ThatOneNeji/pomodoro/cad/original/Pomodoro - Knob.stl

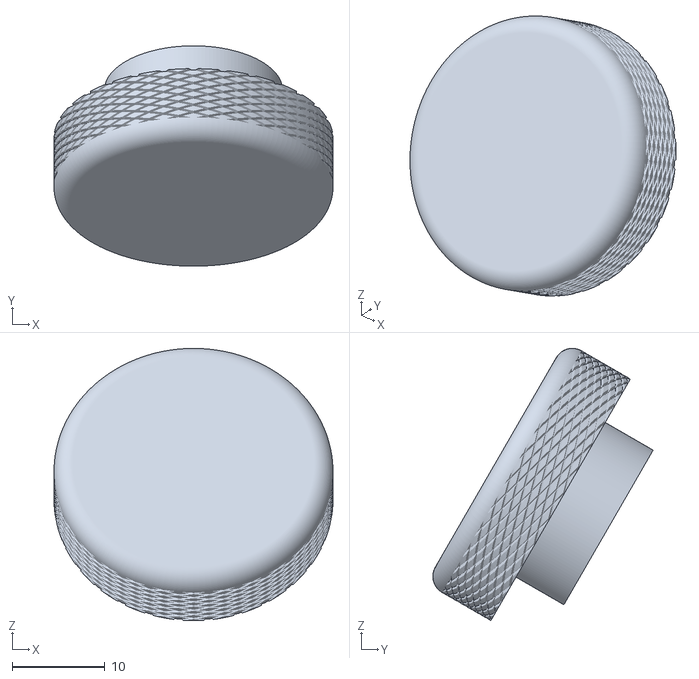
[picture p1: CAD file, 2026-10-10]
cad/original/Pomodoro - Knob.stl
30.0 x 23.7 x 29.3
