ThatOneNeji/pomodoro/src/config.h

/**
 * @file config.h
 * @brief Board wiring (e-paper SPI pins) and user-facing build-time options.
 */
#pragma once

#include <Arduino.h>
#include "credentials.h"
#include <GxEPD2_BW.h>
#include <GxEPD2_GFX.h>

#include "fonts.h"  // declarations only; see fonts.h for why

/// Whether the one-off Anniversary presentation (see anniversary.h) is compiled in. Currently unimplemented.
#define ANNIVERSARY_MODE false

/**
 * @brief Whether the "LPE" meme art (alternate preset icons, running background and long-break
 * images) is compiled in, along with the "LPE Mode" setting that switches to it.
 *
 * Off by default: it costs ~250 KB of flash, and some of the images are third-party works. When
 * off, the setting is hidden and only the neutral assets exist. Which assets count as meme art
 * is marked in assets/manifest.json. Can also be set from platformio.ini with
 * `-DINCLUDE_MEME_ASSETS=1`.
 */
#ifndef INCLUDE_MEME_ASSETS
#define INCLUDE_MEME_ASSETS 0
#endif

/// @name Named font aliases
/// Semantic names for the GFXfont bitmap fonts, used throughout the UI drawing code.
/// @{
#define TITLE_FONT FunnelDisplay_Bold32pt7b       ///< Screen/section titles.
#define MAIN_FONT FunnelDisplay_Bold24pt7b        ///< Primary content text (e.g. preset names).
#define TEXT_FONT FunnelDisplay_Regular14pt7b     ///< General body text.
#define SECONDARY_FONT FunnelDisplay_Bold18pt7b   ///< Secondary/supporting text.
#define SUB_FONT HelvetiPixel24pt7b               ///< Menu bar and subtitle text.
#define SMALL_FONT HelvetiPixel16pt7b             ///< Small/compact text (e.g. speech-bubble messages).
#define SEMI_LARGE_FONT FunnelDisplay_Bold48pt7b  ///< Large emphasis text.
#define LARGE_FONT FunnelDisplay_Bold60pt7b       ///< Largest text (e.g. the countdown display).
/// @}

/// How long the boot splash screen (logo) is shown before preset selection, in milliseconds.
#define SPLASH_DURATION_MS 3000

/// Slow display redraw interval, in milliseconds.
#define REDRAW_INTERVAL_SLOW 1000

/// Concrete GxEPD2 display type in use (480px-wide 4.26" GDEQ0426T82 panel), used wherever display references are
/// typed.
#define DISPLAY_CLASS GxEPD2_BW<GxEPD2_426_GDEQ0426T82, 480>

#define MINUTE 60 * 1000  ///< One minute, in milliseconds; used to size preset durations.

/**
 * @brief One row of the ::PRESETS table: everything Timer::addPreset() needs except the icon and
 * background image, which are resolved at runtime by name (see IconProvider::getPresetIcon()),
 * since they depend on the current LPE-mode setting rather than being fixed per preset.
 */
struct PresetConfig {
    const char *name;                 ///< Preset name, also used as the IconProvider lookup key.
    unsigned long duration;           ///< Work interval duration, in milliseconds.
    unsigned long pauseDuration;      ///< Short break duration, in milliseconds.
    unsigned long longPauseDuration;  ///< Long break duration, in milliseconds.
    unsigned int longPauseAfter;      ///< Number of completed cycles between long breaks.
};

/// The presets registered with Timer at startup (see main.cpp's setup()). Add/remove/edit entries
/// here rather than touching the addPreset() call site.
static const PresetConfig PRESETS[] = {
    {"Coding", 15 * MINUTE, 5 * MINUTE, 10 * MINUTE, 2},
    {"Workshop", 30 * MINUTE, 10 * MINUTE, 20 * MINUTE, 4},
    {"Focus", 8 * MINUTE, 5 * MINUTE, 6 * MINUTE, 4},
};

/* This is the old PRESETS. I needed smaller values for testing
static const PresetConfig PRESETS[] = {
    {"Emails", 5 * MINUTE, 1 * MINUTE, 5 * MINUTE, 4},
    {"Coding", 15 * MINUTE, 5 * MINUTE, 10 * MINUTE, 2},
    {"Focus", 8 * MINUTE, 5 * MINUTE, 6 * MINUTE, 4},
};
*/

#define ENCODER_CLK 32  ///< Encoder clock (A) pin.
#define ENCODER_DT 21   ///< Encoder data (B) pin.

#define ENCODER_STABILITY_DELAY 50          ///< ms to wait after a button press before trusting encoder changes.
#define ENCODER_LOCK_TIME_AFTER_BUTTON 200  ///< Unused; see ENCODER_STABILITY_DELAY, which is what's actually applied.

#define ENCODER_SW 14  ///< Optional encoder push-button pin, passed to Button's constructor in main.cpp.

/// @name E-paper display pin wiring
/// @{
#define EPD_SCK_PIN 18   ///< SPI clock pin.
#define EPD_MOSI_PIN 23  ///< SPI MOSI (data) pin.
#define EPD_CS_PIN 5     ///< SPI chip-select pin.
#define EPD_RST_PIN 16   ///< Display reset pin.
#define EPD_DC_PIN 17    ///< Data/command select pin.
#define EPD_BUSY_PIN 4   ///< Display busy-status input pin.
#define EPD_PWR_PIN 22   ///< Display power-enable output pin.
/// @}

/**
 * @brief Change this to 'true' to use the old style of displaying the remaining time
 *
 */
const static bool timerStyleOld = false;

// #define LANG_AF // Uncomment for Afrikaans text messages
// #define LANG_DE // Uncomment for German text messages

/// @name SNTP time sync
/// Neither of these are sensitive, so (unlike WiFi/MQTT credentials) they live directly here
/// rather than in a gitignored credentials header. See sntp_manager.h.
/// @{
#define SNTP_SERVER "pool.ntp.org"  ///< NTP server to sync the device clock from.
/// POSIX TZ string (not just a UTC offset) so daylight saving is handled automatically; see
/// https://github.com/nayarsystems/posix_tz_db for a lookup table of these by region.
#define SNTP_TIMEZONE "SAST-2"
/// @}

/**
 * @brief Name the device announces on the local network via mDNS, so the web UI is at
 * http://<name>.local/ (default http://pomodoro.local/) and keeps working when the router hands
 * out a new IP. Also used as the WiFi hostname, so router device lists show it. Use a different
 * name per device if you run several. An empty string disables mDNS.
 */
#define MDNS_HOSTNAME "pomodoro"

/// @name MQTT client
/// Broker address/port aren't sensitive so they live here; MQTT_USERNAME/MQTT_PASSWORD are in
/// the gitignored credentials.h instead (see credentials.example.h). An empty
/// MQTT_BROKER_ADDRESS disables MQTT entirely (see mqtt_manager.cpp) — the default, since most
/// checkouts of this repo won't have a broker to connect to.
/// @{
// // #define MQTT_BROKER_ADDRESS "192.168.100.249"  ///< MQTT broker hostname or IP. Empty disables the MQTT client.
#define MQTT_BROKER_ADDRESS ""  ///< MQTT broker hostname or IP. Empty disables the MQTT client.
#define MQTT_BROKER_PORT 1883   ///< MQTT broker port (1883 is the standard unencrypted default).
/// @}
