ThatOneNeji/pomodoro/src/button.cpp

/// @file button.cpp
#include "button.h"
#include "esp_log.h"

/// Log tag for this file, used by ESP_LOGx() calls.
[[maybe_unused]] static const char *TAG = "BUTTON";

static const unsigned long DEBOUNCE_DELAY = 1000;  // ms

Button *Button::instance = nullptr;
bool Button::instanceExists = false;

Button::Button(int pin) : pin(pin) {
    if (instanceExists) {
        ESP_LOGE(TAG, "Only one Button instance allowed!");
        return;
    }

    pinMode(pin, INPUT_PULLUP);
    attachInterrupt(pin, buttonInterruptHandler, FALLING);
    instance = this;
    instanceExists = true;
}

Button::~Button() {
    if (instance == this) {
        instance = nullptr;
        instanceExists = false;
        detachInterrupt(pin);
    }
}

void IRAM_ATTR Button::buttonInterruptHandler() {
    if (!instance)
        return;  // Safety check

    unsigned long currentTime = millis();

    if ((currentTime - instance->lastPressTime) > DEBOUNCE_DELAY) {
        instance->pressed = true;
        instance->lastPressTime = currentTime;
    }
}

bool Button::checkAndClearButtonPress() {
    if (!instanceExists)
        return false;  // Safety check

    if (pressed) {
        ESP_LOGI(TAG, "Button pressed");
        pressed = false;
        return true;
    }
    return false;
}
