ThatOneNeji/pomodoro/src/checkbox.cpp

/// @file checkbox.cpp
#include "checkbox.h"
#include "preferences_manager.h"
#include "esp_log.h"

/// Log tag for this file, used by ESP_LOGx() calls.
[[maybe_unused]] static const char *TAG = "CHECKBOX";

/// Redundant re-declaration of preferences_manager.h's ::preferences; unused here (Checkbox goes through
/// pref_getCheckbox()/pref_putCheckbox() instead).
extern Preferences preferences;

// Unused; Checkbox stores its state as a plain bool via pref_getCheckbox()/pref_putCheckbox() instead.
#define NOVALUE 0     ///< Unused.
#define TRUEVALUE -1  ///< Unused.
#define FALSEVALUE 1  ///< Unused.

Checkbox::Checkbox(Icon *icon, const char *name, const char *key, bool defaultValue)
    : icon(icon), name(name), key(key), defaultValue(defaultValue) {
    load();
}

Checkbox::~Checkbox() { save(); }

Icon *Checkbox::getIcon() { return icon; }

const char *Checkbox::getName() { return name; }

bool Checkbox::isChecked() { return checked; }

void Checkbox::toggle() { checked = !checked; }

void Checkbox::load() {
    checked = pref_getCheckbox(key, defaultValue);

    ESP_LOGI(TAG, "load: key=%s, value=%s", key, checked ? "true" : "false");
}

void Checkbox::save() {
    pref_putCheckbox(key, checked);

    ESP_LOGI(TAG, "save: key=%s, value=%s", key, checked ? "true" : "false");
}

void Checkbox::draw(DISPLAY_CLASS &display, uint16_t x, uint16_t y, uint16_t w, uint16_t h, bool selected) {
    const uint16_t padding = 12;

    display.fillRect(x, y, w, h, GxEPD_WHITE);
    display.drawRoundRect(x, y, w, h, 10, GxEPD_BLACK);

    if (selected) {
        drawPatternInRoundedArea(display, x, y, w, h, 10, Pattern::SparseDots);
    }

    ScaledIcon checkmark = icon_checkmark.scaled(48);

    const uint16_t iconSize = 64;
    if (icon) {
        ScaledIcon scaledIcon = icon->scaled(iconSize);
        display.drawBitmap(x + padding, y + padding, scaledIcon.data, scaledIcon.size, scaledIcon.size, GxEPD_BLACK);
    }

    Bounds bounds = getBounds(display, name, &MAIN_FONT);
    const uint16_t textX = x + padding + iconSize + padding;
    const uint16_t textY = y + h / 2 + bounds.h / 2;

    drawText(display, name, textX, textY, &MAIN_FONT, GxEPD_BLACK);

    display.drawRoundRect(x + w - padding - 64, y + h / 2 - 64 / 2, 64, 64, 10, GxEPD_BLACK);

    if (checked) {
        display.drawBitmap(x + w - padding - 64 / 2 - checkmark.size / 2, y + h / 2 - checkmark.size / 2,
                           checkmark.data, checkmark.size, checkmark.size, GxEPD_BLACK);
    }
}
