ThatOneNeji/pomodoro/(commit log)

2026-03-05 Updated lib_deps, added second board type
2026-03-05 Added pin config so that we only have to change the values in one place
2026-08-15 Serial.print* calls converted to ESP_LOGx
2026-10-10 Keep last-used preset after stopping; run paused breaks in full
    - enterPresetSelection() always reselected index 1, so stopping, cancelling or
    finishing a break jumped to whichever preset happened to be second (now
    "Workshop"). It now keeps the last-used preset; index 0 on first boot.
    - The end-of-break check used millis() - startTime, ignoring time spent
    paused, so a paused break ended early by the paused time. It now uses
    elapsed, which excludes pauses, matching the remaining time shown.
2026-10-10 Add remote timer control and live status over the WebSocket
    /ws is now two-way. Clients send {"cmd": "select"|"start"|"pause"|"resume"|
    "restart"|"stop"|"break"}; the device sends typed messages: "presets" on
    connect, "status" on every state/preset change and once a second, and
    "error" for malformed commands.
    - Timer::handleCommand() applies a command the way the encoder/button does in
    each state, and wakes a blanked display first. The cancel/skip and
    break-confirmation logic moved into shared helpers used by both the knob
    handlers and handleCommand(), so local and remote input can't drift apart.
    - Commands are parsed on the AsyncTCP task and queued (FreeRTOS queue) for
    loop() to ap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
2026-10-10 Add endsAt/deviceTime to WebSocket status
    endsAt (epoch ms, from SNTP time) lets clients count down on their own between
    messages and through a dropped connection; deviceTime lets them correct for
    their clock differing from the device's. Both are null until the clock has
    synced, and endsAt is null unless an interval is actively counting down.
    remainingMs is now computed from the live clock (Timer::getLiveElapsed()).
    Timer::elapsed is only refreshed at the start of each loop(), and an e-paper
    redraw can then block for 1-2 s, so status built after a redraw was stale by
    that much: endsAt jittered by about a second between messages.
2026-10-10 Drive the web timer page from the device
    Replaces the page's fake local 25/5/15 timer with one driven entirely by the
    /ws messages:
    - Preset tabs come from the device's "presets" message; clicking one selects
    it (only while idle), and Start confirms.
    - The countdown runs locally from endsAt (corrected by deviceTime), so it
    keeps going through a dropped connection and resyncs on the next message;
    falls back to remainingMs when the device clock isn't synced.
    - The primary button and the Restart / Break now / Stop buttons follow the
    commands each state accepts, with a progress bar and work/break colours.
    - Buttons are disabled while a command is in flight ("Waiting for the
    device..."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
2026-10-10 Allow the settings page to reach the device from a local dev server
    Opened from e.g. Live Server, settings.html now sends its /wifi and /system
    requests to the device remembered from ?device=<device-ip> (same logic as the
    timer page), and the Back link keeps the parameter.
    Those requests are cross-origin, so the device now answers CORS (including
    the preflight for the JSON POST) for loopback origins only: localhost or
    127.0.0.1 on any port. A blanket "*" would let any website the user visits
    read the config and POST new WiFi credentials. The device's own pages are
    same-origin and unaffected; /ws never needed this.
2026-10-10 Document the WebSocket API and record Caturday decisions
    - websocket.md: every message in both directions, which commands are valid in
    which state, how to show the countdown from endsAt/deviceTime, and the
    planned MQTT topics.
    - caturday.md: decisions on the long press, status screen, graphics/LPE,
    SVG icons and endsAt.
    - roadmap.MD: MQTT publish/subscribe plan, dropping LPE, and the QR code
    idea.
2026-10-10 Bump CI actions to Node 24 versions; pin the runner image
    GitHub flagged the Node 20 action versions as deprecated (already forced
    onto Node 24) and ubuntu-latest moving to Ubuntu 26 from 2026-10-19.
    - checkout v4 -> v7, setup-python v5 -> v7, setup-node v4 -> v7,
    cache v4 -> v6, all running on node24.
    - setup-node v5+ may enable npm caching automatically, which fails without a
    committed lockfile (package-lock.json is gitignored), so it's disabled.
    - runs-on: ubuntu-24.04 instead of ubuntu-latest, to move to Ubuntu 26
    deliberately rather than by surprise.
2026-10-10 Add INCLUDE_MEME_ASSETS build switch; generate icons from Bootstrap SVGs
    Firmware flash: 84.0% -> 68.1% (1,762,641 -> 1,428,629 B, -334,012 B).
    Meme assets are now opt-in. The "LPE" art and the long-break images are only
    compiled in with INCLUDE_MEME_ASSETS (src/config.h, off by default), which
    also enables the "LPE Mode" setting. Besides costing ~250 KB of flash, some
    of these images have copyright problems: bg_pablo is a still from the TV
    series Narcos and bg_what_a_week is a panel from a Tintin comic, both
    copyrighted works, and the remaining meme images are of unclear provenance.
    A default build no longer contains any of them.
    - IconProvider is now the single place that picks every ima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
2026-10-10 Add a Status page to the start screen; share status with GET /system
    The start screen now offers Start | Settings | Status. Status shows five pages
    (Network, Time & MQTT, Device, Firmware, Storage & stats), turned with the
    knob; a press returns to the start screen menu, which previously had no way
    back from any choice.
    - system_status.h: collectSystemStatus() gathers network, time, MQTT,
    hardware, firmware, storage and lifetime statistics in one snapshot, used
    by both the device screen and GET /system so they can't drift apart.
    GET /system keeps its existing keys and gains the new fields.
    - Firmware size is reported against the running app partition: with the
    no_ota partition table,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
2026-10-10 Add a web status page; show Back as an arrow icon
    - status.html shows everything GET /system returns, in sections (Network,
    Time, MQTT, Device, Firmware, Storage, Statistics), refreshing every 5 s.
    The rows are built from a list in the script, so a new field is one line.
    It's reached from a new info-circle icon in the timer page's header.
    - settings.html drops its read-only System card (time sync, MQTT): that now
    lives on the status page, and settings only holds what can be changed.
    - The "<- Back" text link on settings and status is now a Bootstrap
    "arrow-left" icon button matching the header's other buttons, with
    aria-label/title "Back".
    - npm run minify builds status.html too.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
2026-10-10 Move Status and Settings onto the preset selection screen
    The boot splash no longer has a menu: it shows the logo for
    SPLASH_DURATION_MS (config.h, 3 s) and moves on to preset selection by
    itself. Before, the device waited on the splash until someone pressed Start,
    so idle display blanking (which only runs once the timer takes over) didn't
    work after a reboot, and testing needed a button press after every flash.
    - Preset selection gains a Status | Settings row at the top. The knob cycles
    presets -> Status -> Settings; a press starts the preset or opens the
    screen, and both return to preset selection. The selected preset stays
    selected while the cursor is on the top row, so the web UI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
2026-10-10 Update startup hints and docs for the auto-advancing splash
    - index.html: the device no longer waits on a start screen for a press, so
    the "press Start on the device" hints now say it's still starting up.
    - websocket.md: "not ready" now only happens during the boot splash;
    commands sent while Status or Settings is open are applied on leaving it.
    - caturday.md: section 11 records the splash/selection/running screen
    changes, and pins two open decisions (break decorations, the long press).
2026-10-10 Bring the Caturday plan up to date
    - A status table at the top, with each section's state and its PR, plus
    single "Still to do" and "Still to test" lists.
    - Tick the finished items (all of section 2, and the section 8 checks that
    were verified on the device), and mark progress on the suggested order.
    - Section 7 (long press) is marked as not started and pinned.
    - The intro and the flash figure now reflect the work, not just the prep:
    83.6% before, 64.6% after.
2026-10-10 Fix empty slots in message arrays that could crash the running screen
    Msgs::CHAT_GPT_FACTS was declared std::array<const char *, 42> but lists 41
    facts, in all three languages, so its last slot was a null pointer. It's part
    of the pool every running speech-bubble message is picked from (42 + 8 slots),
    so about 1 in 50 picks returned nullptr, which drawRunning() turns into a
    std::string: undefined behaviour, typically a crash and reboot. A new message
    is picked every 5 minutes. RESTARTTIMERMSG had the same mismatch (4 declared,
    3 listed), though nothing uses it.
    - The arrays in src/i18n/ now let the compiler count their entries
    (`static constexpr std::array NAME = {...}`), so the size can'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
2026-10-10 Use one running message for every preset; fixes "Unknown preset"
    Timer::getRunningMessage() matched "Emails", "Coding" and "Focus" by name and
    returned the literal "Unknown preset" for anything else, so the Workshop
    preset's speech bubble showed that. But all three per-preset messages drew
    from the same pool (trivia + generic lines); they only differed in empty LPE
    additions.
    Messages::Preset_Email/Coding/Focus_Message are now one
    Messages::Preset_RunningMessage used for every preset, so Workshop works and
    presets added to PRESETS in config.h need nothing here. The two empty LPE
    lists became one (lpeRunningMessages), so LPE behaviour is unchanged.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
2026-10-10 Mark the Caturday plan done
    The Workshop running message (PR #7) and the break screen icons (PR #8) were
    the last open items. The status table now shows every section done or
    dropped; what remains is the "Still to test" list and the roadmap items.
    Also records the empty-message-slot crash fix from PR #7.
2026-10-10 Remove hand-placed line breaks from messages; replace unsupported ß
    - Messages wrap automatically now, so the manual '\n's in the facts and
    generic messages are gone, in en, af and de. A replay with the font's
    glyph widths shows every message (53 per language) fits the speech bubble
    in at most 3 lines.
    - Four facts in af.h/de.h used "ß", which the 7-bit GFX fonts don't contain;
    they now use "ss". (af.h currently holds the German facts as a
    placeholder.)
2026-10-10 Show free memory against the total, plus its low point since boot
    "Free memory: 161 KB" on its own gave no sense of whether that's good or
    bad. The status page and the device's Status screen now show it against the
    total heap ("161 KB of 263 KB (61%)") and add the lowest free memory since
    boot, the real health indicator: if that keeps falling over days, something
    is leaking. GET /system gains totalHeapBytes and minFreeHeapBytes.
2026-10-10 Announce the device as pomodoro.local via mDNS
    The web UI is now also at http://pomodoro.local/, which keeps working when
    the router hands out a new IP, so the IP no longer has to be looked up and
    typed.
    - MDNS_HOSTNAME in config.h (default "pomodoro"; empty disables it). It's
    also set as the WiFi hostname, so router device lists show the name.
    - mDNS (ESPmDNS) starts once WiFi has an IP and announces the web server as
    an HTTP service; it only initialises once and keeps itself going across
    reconnects.
    - The device's Status screen shows http://pomodoro.local/ as the web page
    (the IP keeps its own row); the web status page gains a Hostname row, and
    GET /system a "hostname" field.
    -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
2026-10-10 Add battery power, case changes and branding to the roadmap
2026-10-10 Rename strings.h to messages.h
    The C library has its own <strings.h>, and the system's string.h includes
    it. With src/ on the include path, that picked up ours instead: it broke
    the host test build, and on the ESP32 it was quietly supplying the
    Messages API to timer_waiting_for_confirmation.cpp, which now includes it
    directly. No change to the firmware or its size.
2026-10-10 Add host unit tests for the timer, run in CI
    pio test -e native builds the real timer sources against stand-ins for the
    hardware in test/fakes/ (a display that draws nothing, fake time, settings
    in memory) and runs test/test_timer/: TMR-01 to TMR-10 from test/README.md.
    test.yml runs them on every PR.
    The roadmap moves power measurements down until there's a meter to measure
    with.
2026-10-10 Make the case editable as code, with a script to rebuild the STLs
    The original STLs move to cad/original/ and are never edited.
    cad/build_case.py (run with FreeCAD: npm run case) applies our edits and
    writes the printable files to stl/. A part without edits is copied byte
    for byte; an edited part is turned into a solid, edited, and meshed again.
    npm run case:check proves the round trip is lossless (volume within
    0.0003%, bounds exact). No edits yet, so stl/ is unchanged.
    Onshape isn't needed: its exports need a signed-in account with WebGL or
    API keys, and the design history can't be exported anyway.
2026-10-10 Add Settings → Shut down: clear the screen, tell web clients, deep sleep
    The last Settings row becomes two buttons, Back and Shut down. Shut down
    (src/power.cpp) sends a WebSocket shutdown message, switches the LED off,
    clears the e-paper panel, closes the connections and puts the ESP32 into
    deep sleep; a knob press switches it back on (a fresh boot). The web page
    shows "switched off" and reconnects by itself once the device is back.
    The panel clearing moves to clearPanel() in gfx_utils, shared with idle
    blanking. The roadmap's MQTT plan notes that a clean shutdown must publish
    "offline" itself, since the broker only sends the last will on an
    unexpected drop. Flash: 56.5% -> 56.8% (+6.9 K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
2026-10-10 Log the USB power meter over Bluetooth; record the first readings
    scripts/um34c_log.py reads a RuiDeng UM34C over its Bluetooth serial port
    once a second, can write a CSV, and prints the average, minimum and maximum
    at the end. test/README.md explains how to measure with it and adds PWR-06
    (deep sleep after Shut down).
    First results at USB 5.2 V: 88.5 mA running with WiFi (PWR-01), 19.4 mA
    after Shut down (PWR-06); blanking (PWR-05) needs a clean run. The roadmap
    turns them into battery estimates: ~145 mA through a 5 V booster against
    ~88 mA through a direct 3.3 V regulator.
2026-10-10 Record the WiFi on/off and blanked-display power readings
    Idle on the blanked selection screen at USB 5.2 V: 83.8 mA with WiFi on
    (PWR-05), 79.3 mA with WiFi off (PWR-03, measured on USB). The CPU, not
    the radio, is most of the draw, so the roadmap points the next savings at
    the CPU clock and light sleep.
2026-11-09 Pin the ESP32 platform to 7.0.1
    platformio.ini asked for any espressif32, so a fresh install (CI after its
    cache expired) got 8.0.0, with Arduino core 3.x. NeoPixelBus 2.8.4 doesn't
    link against it (undefined dmaItemInit), which failed the firmware check on
    PR #23. 7.0.1 (Arduino core 2.0.17) is the version the device runs and was
    tested with. Moving to 8.x should be a deliberate upgrade.
2026-11-09 Add the platform 8 / Arduino core 3 upgrade to the roadmap
    Blocked on NeoPixelBus, which doesn't link on core 3. Lists why the
    upgrade is worth doing, what it doesn't bring, and a checklist.
